Packet-Radio-Users-Group/QRP_AM_Transceiver_JK1MLY/README.md

ブロックダイアグラムが学べる　QRPトランシーバ基板

無線機の基本的な動作を知るため、振幅変調（amplitude modulation）を使った簡易的な無線機を作り、回路の定数やデバイスを変えたり、動作波形を見たりするする基板について扱う

以下の構成でファイルは保存する

assembly  提供する基板に部品を実装する手引き　pdf版の回路図、excel版の部品表を含む

caddata   KiCadのデータ

document  使っている部品、基板などに関する情報

guidance  どのように実験をしていくかの手引き
