Packet-Radio-Users-Group/QRP_AM_Transceiver_JK1MLY/caddata/README.md

KICadデータ

am-pcb1
　思い立って最初に作ったもの
（この基板で実験して、28M・10mWの免許を取得）

am-pcb2
　pcb1を作り直そうとしたもの
（リファイン前提で先に番号を取ったが色々と変えることにしてボツ）

am-pcb3
　受信のミキサをICにしたもの
（動作を学ぶためにはトランジスタの考えに戻ってボツ）

am-pcb4
　実験用として使うための改良
（ハムフェア2024で頒布）
