Packet-Radio-Users-Group/QRP_AM_Transceiver_JK1MLY/document/pcb4-7m-bom.xls

/Users/inaba/Documents/KICad/Feb28/pcb4/pcb4-7m/pcb4-7m.kicad_sch
2024 August 12, Monday 16:06:50
Qty | Reference(s) | Value | DNP | Datasheet
2 | C1, C2 | 100u |  | https://akizukidenshi.com/catalog/g/g110598/
27 | C3, C4, C5, C6, C7, C8, C9, C11, C21, C31, C32, C33, C39, C52, C53, C55, C56, C58, C60, C61, C71, C74, C78, C80, C91, C92, C93 | 0.1u |  | https://akizukidenshi.com/catalog/g/g113582/
10 | C12, C13, C14, C16, C22, C41, C62, C73, C79, C86 | 1000p |  | http://www.maroon.dti.ne.jp/satodenki/cap.html#celamic50v
9 | C15, C24, C25, C36, C37, C63, C65, C67, C72 | 100p |  | http://www.maroon.dti.ne.jp/satodenki/cap.html#celamic50v
1 | C23 | 120p |  | http://www.maroon.dti.ne.jp/satodenki/cap.html#celamic50v
2 | C26, C68 | 22p |  | http://www.maroon.dti.ne.jp/satodenki/cap.html#celamic50v
1 | C34 | 330p |  | http://www.maroon.dti.ne.jp/satodenki/cap.html#celamic50v
5 | C35, C45, C46, C47, C48 | 150p | DNP | http://www.maroon.dti.ne.jp/satodenki/cap.html#celamic50v
2 | C38, C66 | 100p | DNP | http://www.maroon.dti.ne.jp/satodenki/cap.html#celamic50v
2 | C42, C44 | 3300p |  | http://www.maroon.dti.ne.jp/satodenki/cap.html#celamic50v
1 | C43 | 4700p |  | http://www.maroon.dti.ne.jp/satodenki/cap.html#celamic50v
8 | C51, C54, C57, C59, C75, C76, C77, C81 | 10u |  | https://akizukidenshi.com/catalog/g/g103095/
4 | C64, C94, C95, C96 | 10p | DNP | http://www.maroon.dti.ne.jp/satodenki/cap.html#celamic50v
1 | C69 | 30pF | DNP | https://akizukidenshi.com/catalog/g/g115472/
2 | C82, C84 | 470p |  | http://www.maroon.dti.ne.jp/satodenki/cap.html#celamic50v
1 | C83 | 820p |  | http://www.maroon.dti.ne.jp/satodenki/cap.html#celamic50v
1 | C85 | 10p |  | http://www.maroon.dti.ne.jp/satodenki/cap.html#celamic50v
1 | D21 | 1S2638 | DNP | https://akizukidenshi.com/catalog/g/g113795/
2 | D81, D82 | 1SS106 |  | https://akizukidenshi.com/catalog/g/g113881/
1 | D91 | LED-G |  | https://akizukidenshi.com/catalog/g/g111637/
1 | D92 | LED-R |  | https://akizukidenshi.com/catalog/g/g111577
1 | IC51 | UTC7642 |  | https://akizukidenshi.com/catalog/g/g112082/
2 | J91, J92 | Conn_Coaxial | DNP | https://akizukidenshi.com/catalog/g/g101422/
1 | J93 | AudioJack4 | DNP | https://akizukidenshi.com/catalog/g/g106070/
1 | J94 | AudioJack2_Ground | DNP | https://akizukidenshi.com/catalog/g/g112478/
1 | J95 | AudioJack3 | DNP | https://akizukidenshi.com/catalog/g/g102460/
1 | K91 | Y14H-1C-9DS | DNP | https://akizukidenshi.com/catalog/g/g102003/
2 | L11, L71 | 100u |  | https://akizukidenshi.com/catalog/g/g103966/
1 | L21 | 10u | DNP | https://akizukidenshi.com/catalog/g/g103963/
1 | L22 | 100u | DNP | https://akizukidenshi.com/catalog/g/g103966/
2 | L41, L42 | 4.7u |  | https://akizukidenshi.com/catalog/g/g103962/
1 | L61 | 1u | DNP | https://akizukidenshi.com/catalog/g/g103961/
2 | L81, L82 | 1u |  | https://akizukidenshi.com/catalog/g/g103961/
1 | Q11 | BF256B |  | https://akizukidenshi.com/catalog/g/g117515/
4 | Q21, Q31, Q61, Q71 | 2SC1959 |  | https://akizukidenshi.com/catalog/g/g113827/
7 | R11, R12, R15, R21, R31, R35, R61 | 100 |  | https://akizukidenshi.com/catalog/g/g125101/
3 | R13, R53, R76 | 100k |  | https://akizukidenshi.com/catalog/g/g125104/
2 | R14, R75 | 22k |  | https://akizukidenshi.com/catalog/g/g125223/
6 | R22, R23, R32, R62, R63, R71 | 47k |  | https://akizukidenshi.com/catalog/g/g118208/
1 | R24 | 100 | DNP | https://akizukidenshi.com/catalog/g/g125101/
1 | R25 | 10k | DNP | https://akizukidenshi.com/catalog/g/g108012/
1 | R26 | 10k | DNP | https://akizukidenshi.com/catalog/g/g125103/
2 | R27, R64 | 2.2k |  | https://akizukidenshi.com/catalog/g/g125222/
1 | R28 | 0 | DNP | https://akizukidenshi.com/catalog/g/g125000/
1 | R29 | 0 |  | https://akizukidenshi.com/catalog/g/g125000/
1 | R33 | 10k |  | https://akizukidenshi.com/catalog/g/g125103/
1 | R34 | 220 |  | https://akizukidenshi.com/catalog/g/g125221/
1 | R51 | 3.3k |  | https://akizukidenshi.com/catalog/g/g125332/
2 | R52, R74 | 10 |  | https://akizukidenshi.com/catalog/g/g125100/
1 | R54 | 10k |  | https://akizukidenshi.com/catalog/g/g108012/
1 | R72 | 6.8k |  | https://akizukidenshi.com/catalog/g/g125682/
1 | R73 | 22 |  | https://akizukidenshi.com/catalog/g/g103821/
1 | R81 | 1M | DNP | https://akizukidenshi.com/catalog/g/g125105/
2 | R91, R92 | 1k |  | https://akizukidenshi.com/catalog/g/g125102/
1 | T11 | 7T7 |  | http://www.maroon.dti.ne.jp/satodenki/l.html#fcz
2 | T21, T61 | 7T7 |  | http://www.maroon.dti.ne.jp/satodenki/l.html#fcz
1 | T31 | 7T1R0 |  | http://www.maroon.dti.ne.jp/satodenki/l.html#fcz
2 | T41, T42 | 7T1R0 | DNP | http://www.maroon.dti.ne.jp/satodenki/l.html#fcz
1 | T62 | 7T7 | DNP | http://www.maroon.dti.ne.jp/satodenki/l.html#fcz
1 | T71 | 7T7 |  | http://www.maroon.dti.ne.jp/satodenki/l.html#fcz
1 | T91 | 7T50 | DNP | http://www.maroon.dti.ne.jp/satodenki/l.html#fcz
1 | U41 | 455BU | DNP | https://akizukidenshi.com/catalog/g/g116045/
2 | U51, U71 | LM386 |  | https://akizukidenshi.com/catalog/g/g114548/
1 | U91 | Microphone | DNP | https://akizukidenshi.com/catalog/g/g101810/
1 | X21 | 6.7458M |  | http://www.maroon.dti.ne.jp/satodenki/l.html#hc49
1 | X61 | 7.195M |  | http://www.maroon.dti.ne.jp/satodenki/l.html#hc49
