Packet-Radio-Users-Group/QRP_AM_Transceiver_JK1MLY/assembly/README.md

組み立て

一般的な電子工作の手引きを探して下さい
部品の実装場所、定数などはdocument下のファイルを見て下さい
