Packet-Radio-Users-Group/QRP_AM_Transceiver_JK1MLY/guidance/step-by-step.txt

実験の手引き

ブロック図

送信
MIC---MOD---LPF---ANT
       |
       |
      TLO

受信
ANT---AMP---MIX---BPF---DET---SPK
             |
             |
            RLO

順番に作っていく

DET
AMラジオ用のICを使っている受信用の回路
適当に線をつなぐことでAMラジオが聞こえることで動作確認
ユニバーサル部にあるイヤホン端子を介して接続することも可能

RFチェッカー
ユニバーサル部分にダイオードの検波回路を組む
オシロスコープが使える場合には不要

RLO
受信した周波数を変えるための受信用の発振回路
RFチェッカーのレベルが高くなるように調整

TLO
送信する周波数を作るための発振回路
RFチェッカーのレベルが高くなるように調整

AMP
受信した信号を増幅するための回路
TLOからの信号のレベルを下げて入力
RFチェッカーのレベルが高くなるように調整

MIX
受信した信号の周波数を変換するための回路
AMPからの信号を入力
この段階で調整は無し

BPF
選択度を少しでも上げる場合はT41を使用
TLOとRLOの差が455kHz程度にできる場合はU81を使用
RFチェッカーのレベルが高くなるようMIXを調整
T41を使う場合のカップリングは10pF程度

MOD + LPF
AM変調するための回路
TLOからの信号をMODに入れる（本来の接続）
マイクは接続しない
RFチェッカーのレベルが高くなるように調整

マイクを接続
ユニバーサル部にあるパターンを使って接続することも可能
ユニバーサル部にあるイヤホン端子を介して接続することも可能
イヤホン兼用の4Pタイプではないので注意

送受とも電源を供給
送信している電波が聞こえるか確認
マイクとスピーカの位置によってはハウリング

送受切替
2回路のスイッチでアンテナと電源を切替
ON-OFF-(ON)タイプを使うと電源スイッチを兼ねることも可能
　例MS500IB NKK A-29AP

パワーアップ
アンテナさえ付けなければ微弱程度な状態から改造
　220Ωの抵抗を小さくor無くすと10mW程度になるハズ

エミッタ注入
ローカルをベースからエミッタに変更

発振回路の実験
バリキャップを使って周波数可変にしてみる
　受信帯域幅が広いので実用としての意味はない

免許の申請
実際に電波を出せる無線局にしてみる

選んだ周波数
  16.9344  CD 41.1k
  28.375   PAL 795x596

他の周波数
　例7.181と7.000
