Packet-Radio-Users-Group/QRP_AM_Transceiver_JK1MLY/document/pcb4-50m-cir.pdf

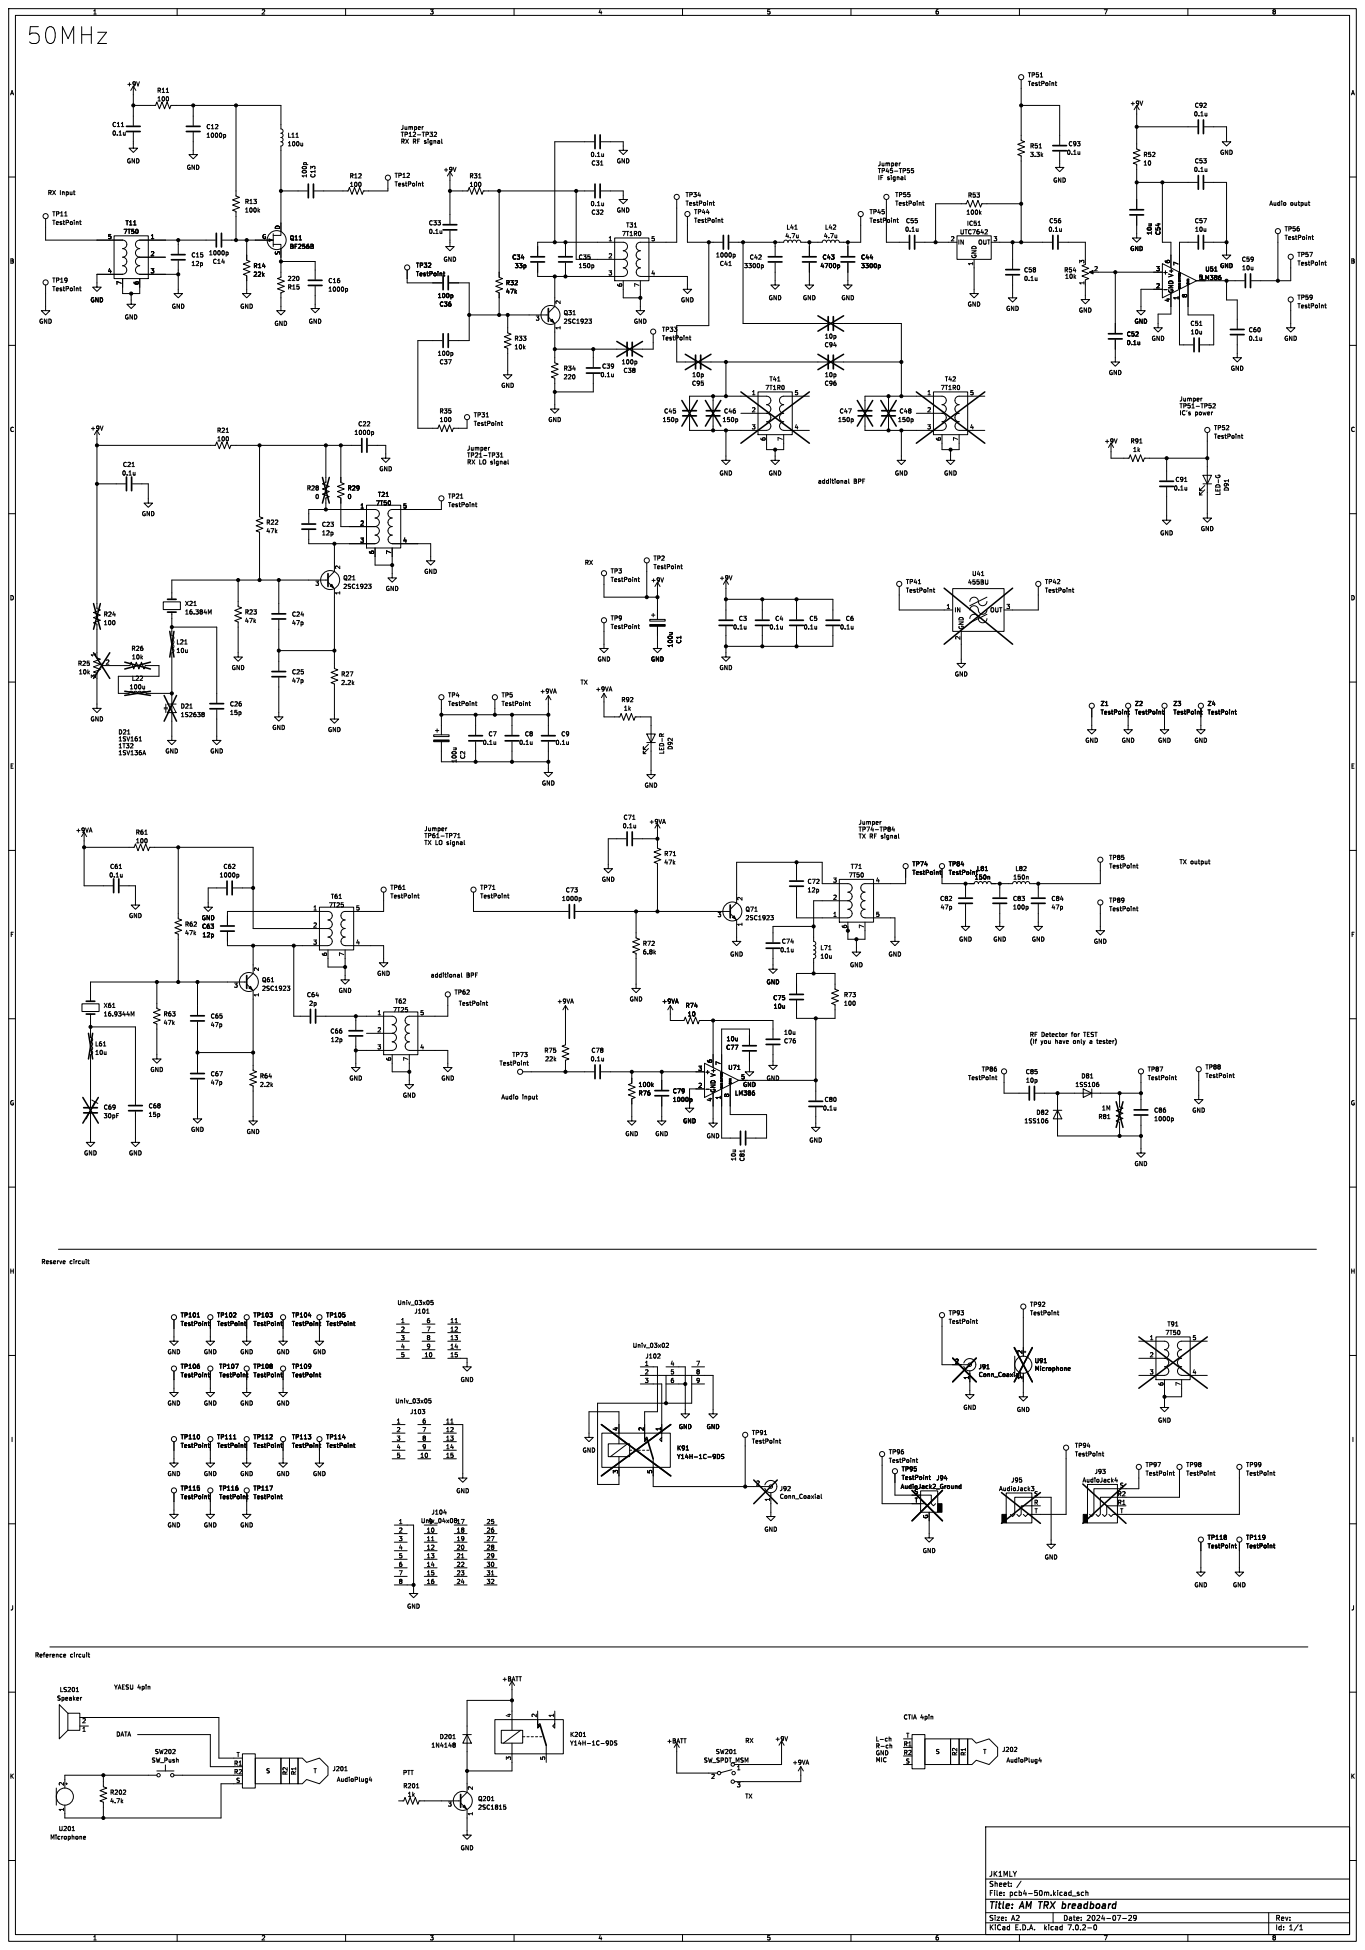
[picture p9: page 1]

Jumper TP12-TP32 RX RF signal

Jumper TP21-TP31 RX LO signal

Jumper TP74-TP84 TX RF signal

RF Detector for TEST
(If you have only a tester)

L-ch R-ch GND MIC

Id: 1/1 Title: AM TRX breadboard
