Packet-Radio-Users-Group/QRP_AM_Transceiver_JK1MLY/document/pcb4-28m-as.pdf

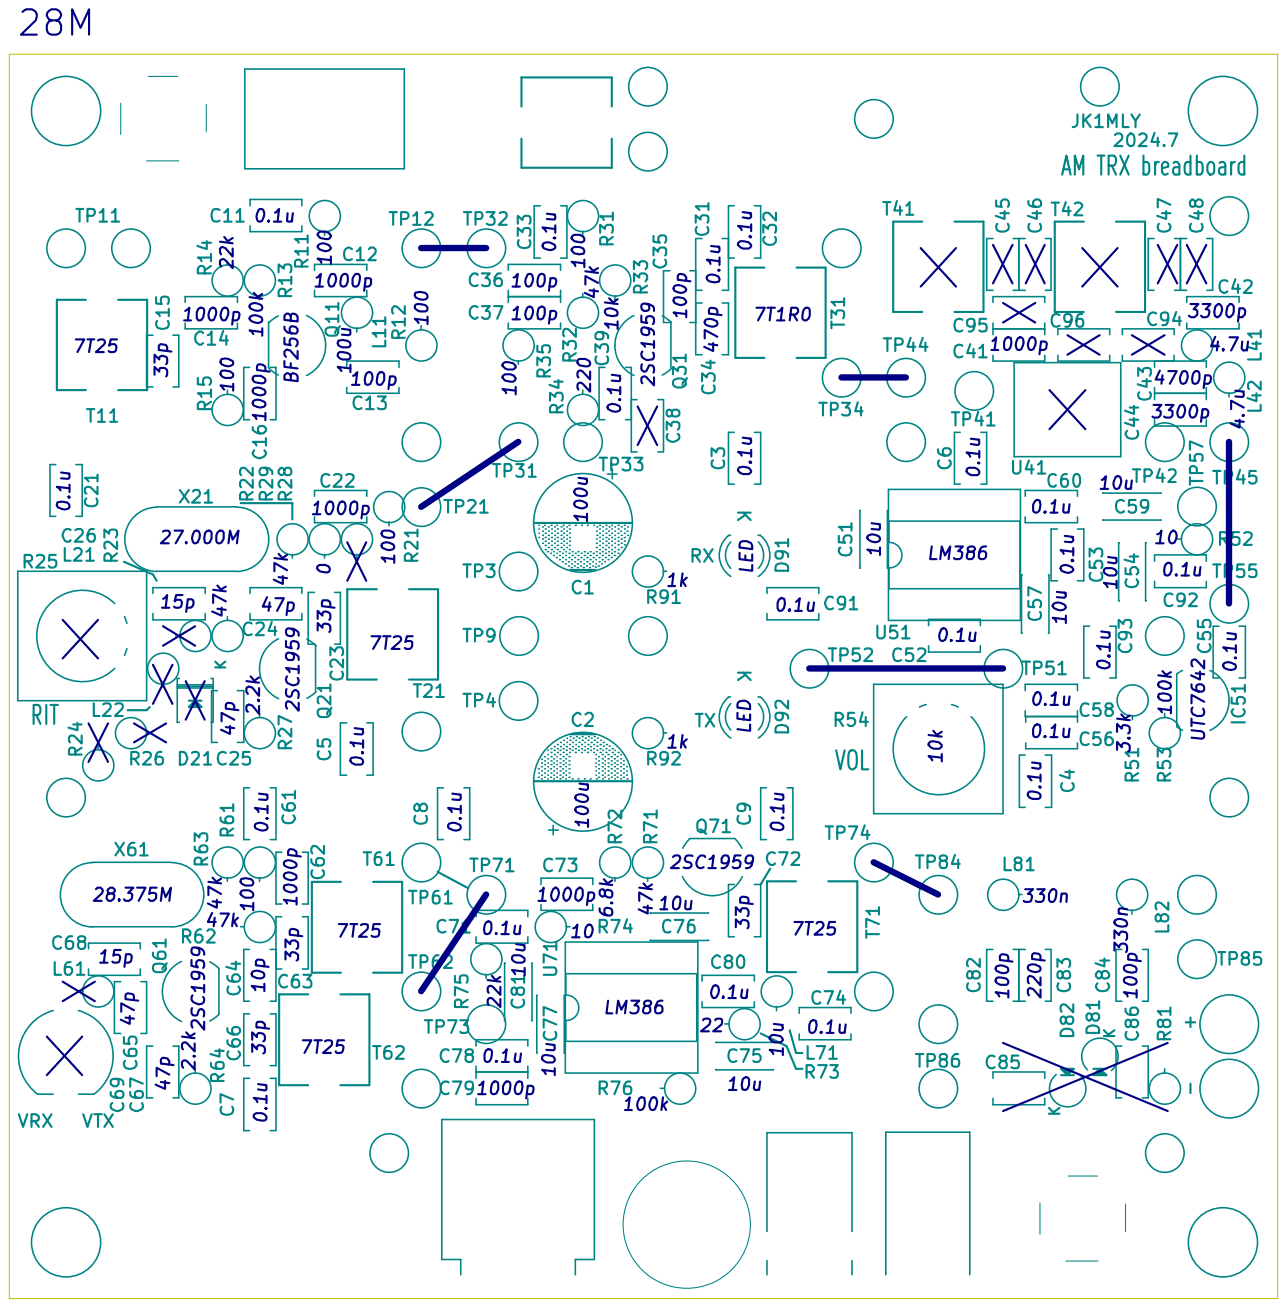
[picture p10: page 1]
