Packet-Radio-Users-Group/QRP_AM_Transceiver_JK1MLY/document/pcb4-50m-as.pdf

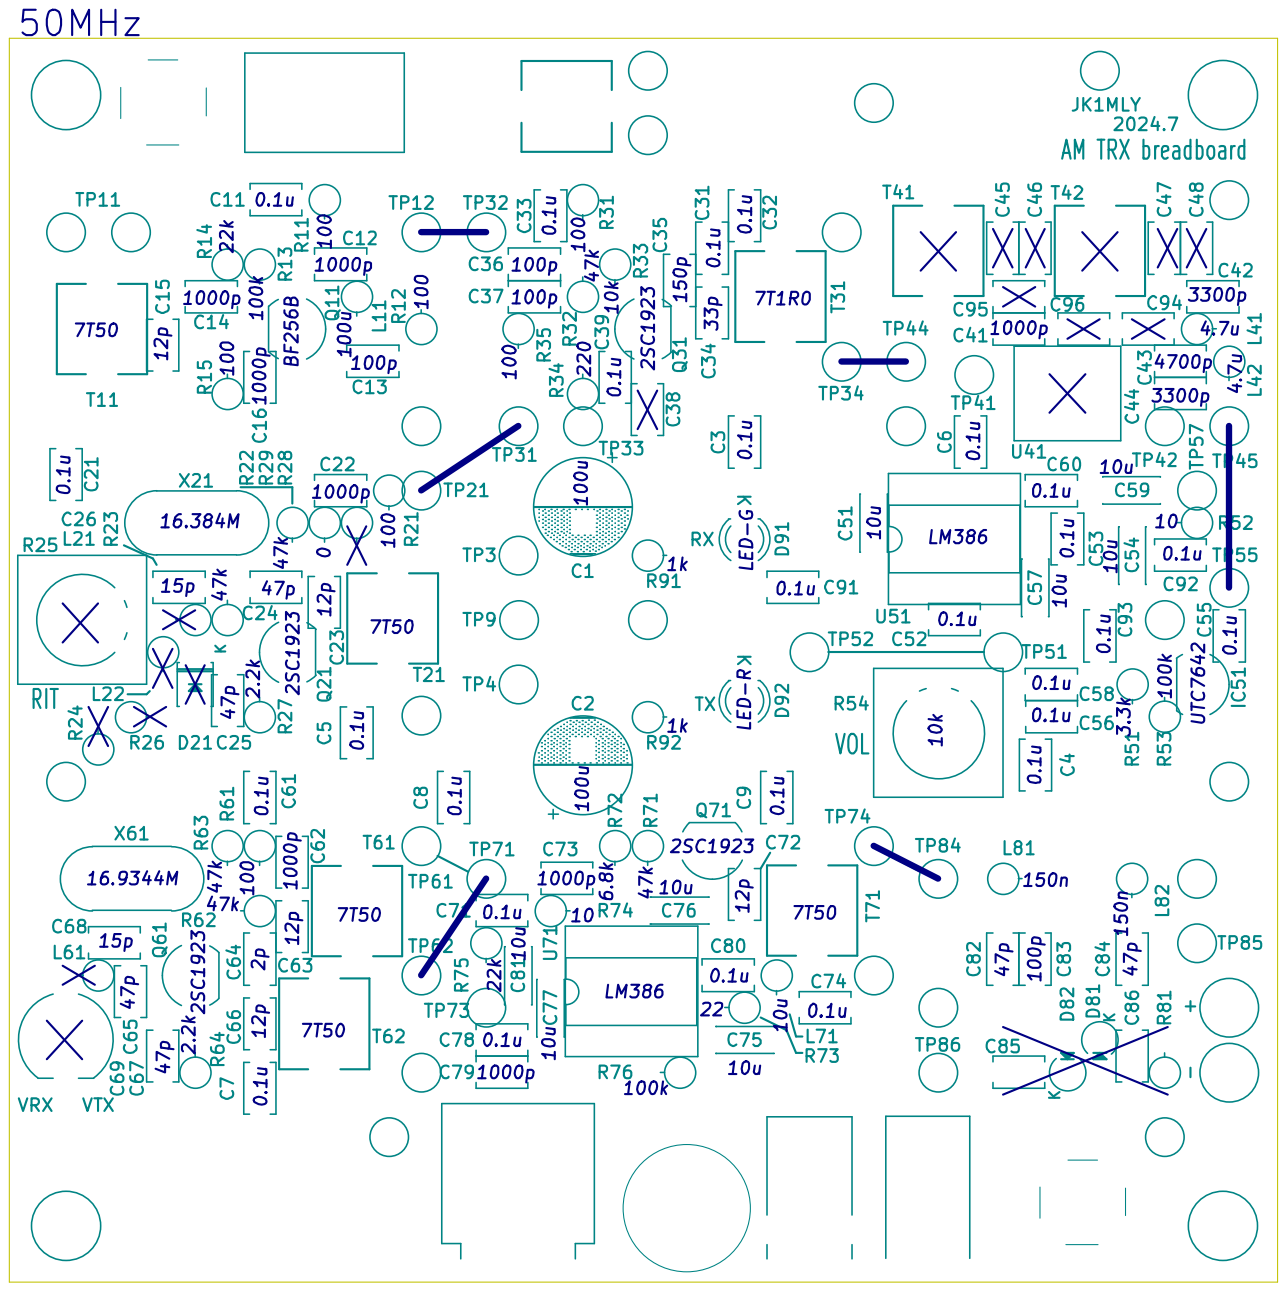
[picture p11: page 1]
