Packet-Radio-Users-Group/QRP_AM_Transceiver_JK1MLY/document/pcb4-7m-as.pdf

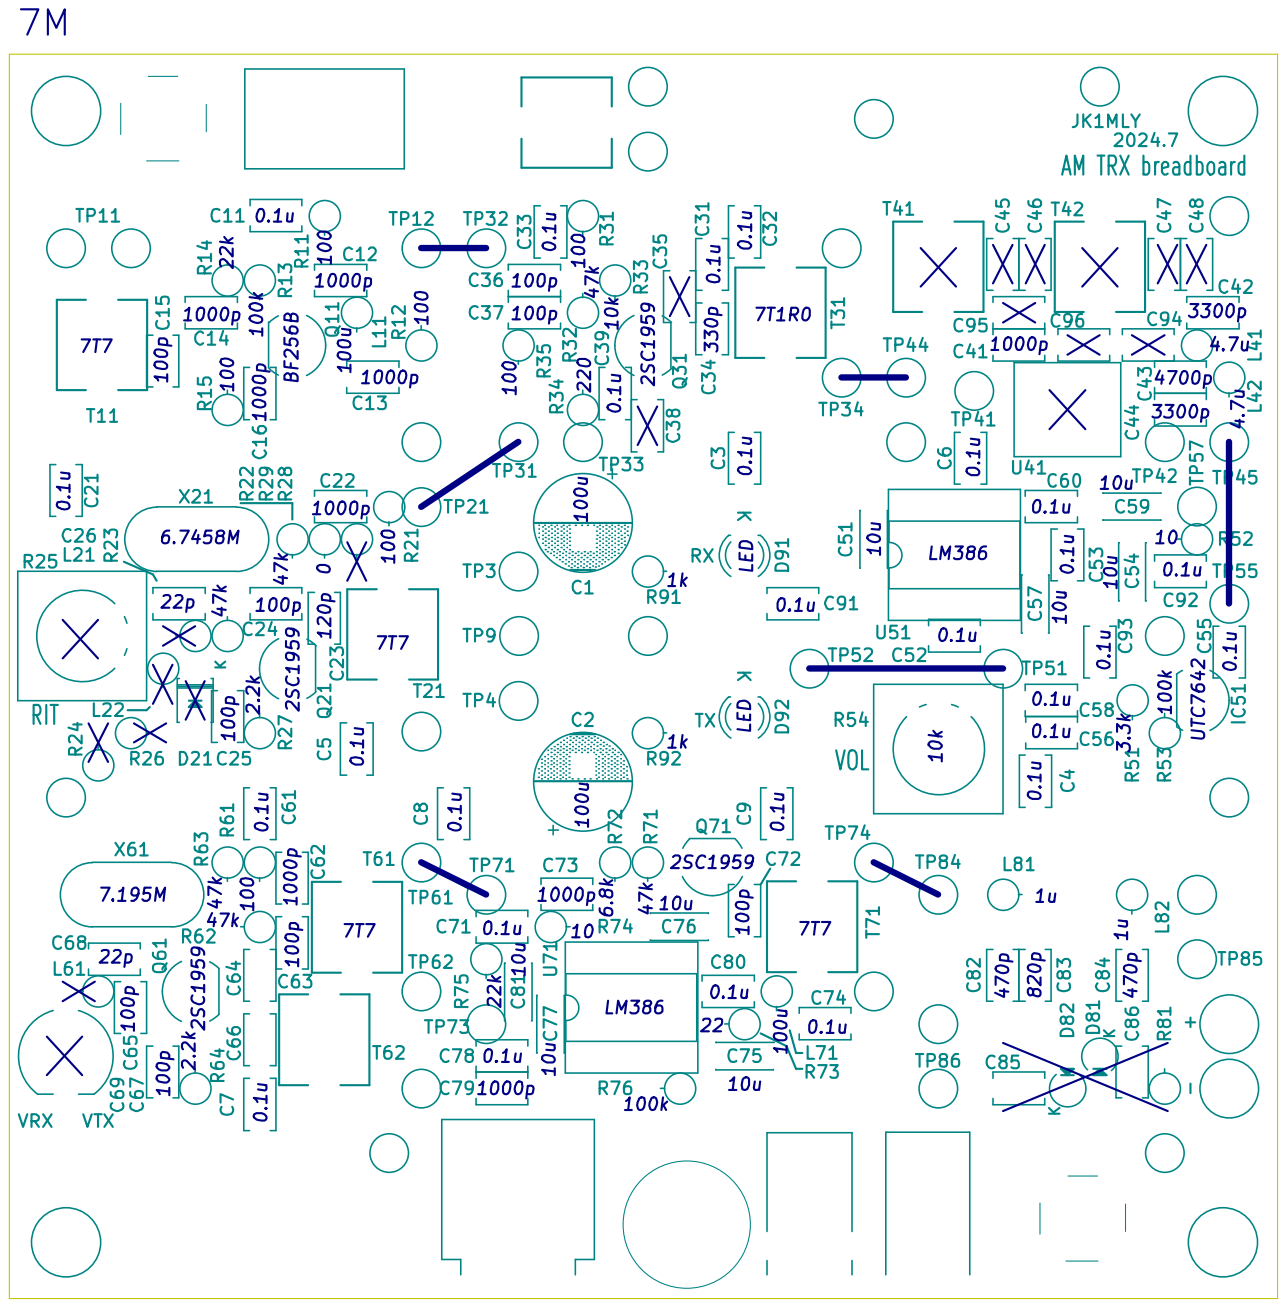
[picture p12: page 1]
