Packet-Radio-Users-Group/QRP_AM_Transceiver_JK1MLY/document/pcb4-7m-cir.pdf

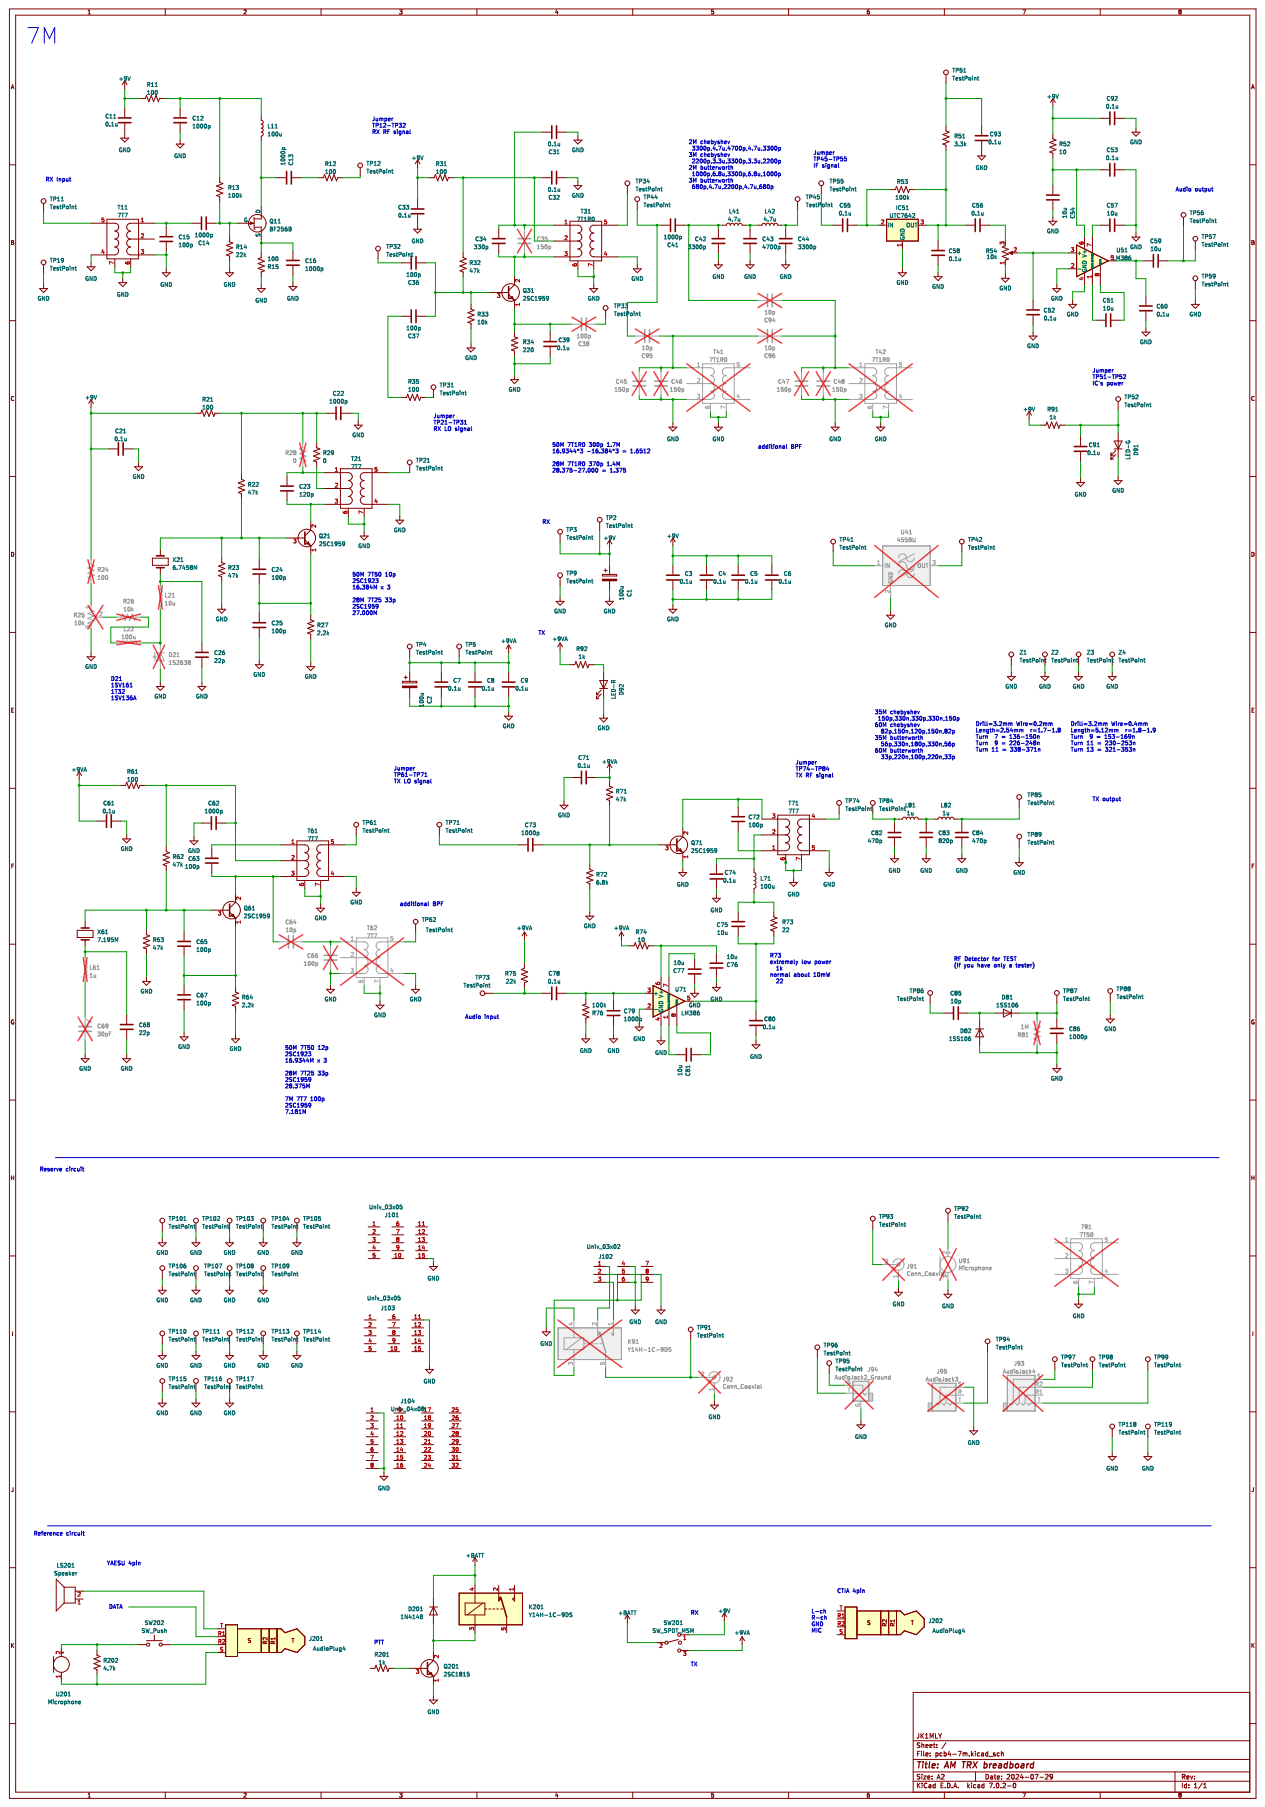
[picture p13: page 1]
