Packet-Radio-Users-Group/QRP_AM_Transceiver_JK1MLY/caddata/twint/twint.kicad_pcb

## KiCad design caddata/twint/twint.kicad_pcb (2024-08-23)

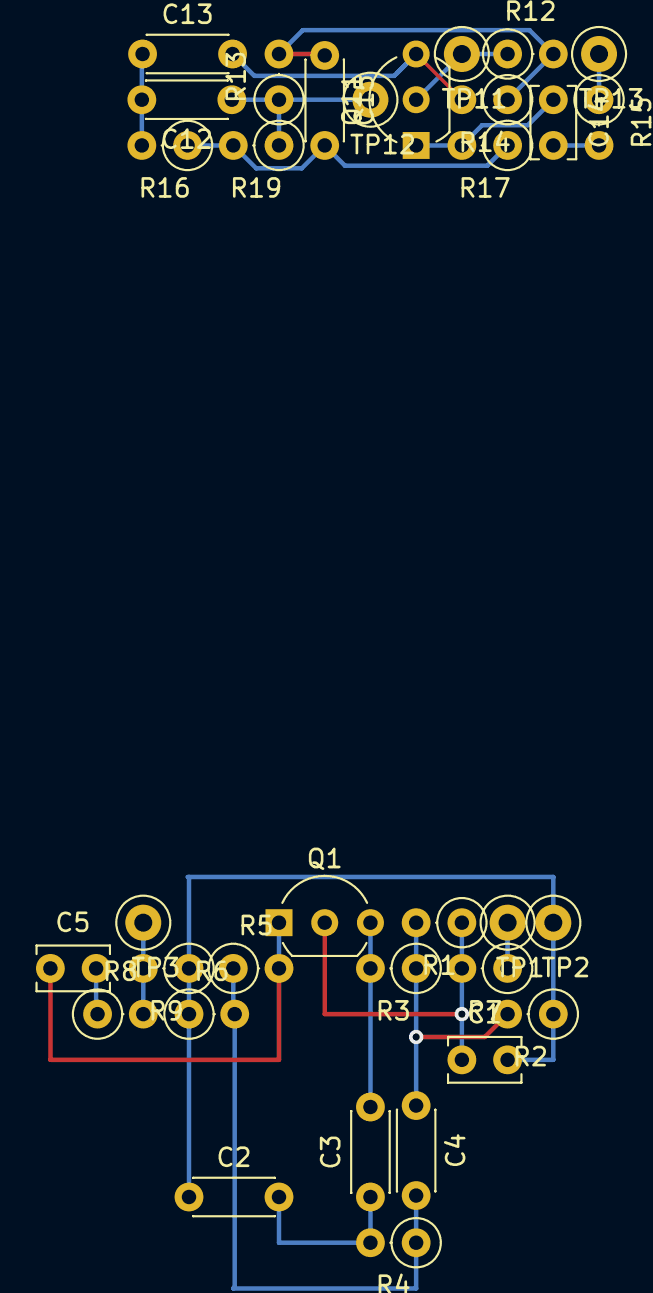
[picture p14: board twint.kicad_pcb from above]

Board: 2 copper layers, 33 parts (0 on the bottom side), 18 nets.

Parts:
C1, C5, C14: 0.1u; C_Disc_P2.54mm
C2, C3, C12, C13: 0.01u; C_Disc_P5.12mm
C4, C15: 0.033u; C_Disc_P5.12mm
Q1, Q11: 2SC1815; TO-92_Inline_Wide
R1, R12: 22k; R_Axial_DIN0207_L6.3mm_D2.5mm_P2.54mm_Vertical
R2, R13: 33k; R_Axial_DIN0207_L6.3mm_D2.5mm_P2.54mm_Vertical
R3: 10k; R_Axial_DIN0207_L6.3mm_D2.5mm_P2.54mm_Vertical
R4, R16: 4.7k; R_Axial_DIN0207_L6.3mm_D2.5mm_P2.54mm_Vertical
R5, R7, R17: 100; R_Axial_DIN0207_L6.3mm_D2.5mm_P2.54mm_Vertical
R6, R19: 3.3k; R_Axial_DIN0207_L6.3mm_D2.5mm_P2.54mm_Vertical
R8, R15: 100k; R_Axial_DIN0207_L6.3mm_D2.5mm_P2.54mm_Vertical
R9: 1k; R_Axial_DIN0207_L6.3mm_D2.5mm_P2.54mm_Vertical
R14: 15k; R_Axial_DIN0207_L6.3mm_D2.5mm_P2.54mm_Vertical
TP1, TP11: VCC; TestPoint_Loop_D2.50mm_Drill1.0mm
TP2, TP12: GND; TestPoint_Loop_D2.50mm_Drill1.0mm
TP3, TP13: OUT; TestPoint_Loop_D2.50mm_Drill1.0mm

Connections:
GND: C1.2, C2.1, C12.1, R2.1, R6.1, R9.1, R13.1, R19.1, TP2.1, TP12.1
unnamed: C2.2, C3.1, R4.2
unnamed: C4.1, R1.2, R2.2, R3.1
unnamed: C4.2, R4.1, R5.1, R6.2
unnamed: C5.2, R8.1
unnamed: C12.2, C13.1, R16.2
unnamed: C14.2, R15.2
unnamed: C15.1, R12.2, R13.2, R14.1
unnamed: C15.2, R16.1, R17.1, R19.2
unnamed: C3.2, Q1.3 (B), R3.2
unnamed: C1.1, Q1.2 (C), R1.1, R7.2
unnamed: C5.1, Q1.1 (E), R5.2
unnamed: C13.2, Q11.3 (B), R14.2
unnamed: Q11.2 (C), R12.1
unnamed: C14.1, Q11.1 (E), R17.2
unnamed: R7.1, TP1.1
unnamed: R8.2, R9.2, TP3.1
unnamed: R15.1, TP13.1
