Packet-Radio-Users-Group/QRP_AM_Transceiver_JK1MLY/(commit log)

2024-07-14 Add files
    KICADデータ2種am-pcb1と3を追加
    [am-pcb1-B_Cu.gbr, am-pcb1-B_Mask.gbr, am-pcb1-B_Paste.gbr, am-pcb1-B_Silkscreen.gbr, am-pcb1-Edge_Cuts.gbr, am-pcb1-F_Cu.gbr, am-pcb1-F_Mask.gbr, am-pcb1-F_Paste.gbr]
2024-07-18 step-by-step.txt を更新
2024-07-29 update
    add am-pcb2 ,4
    [am-pcb2-B_Cu.gbr, am-pcb2-B_Mask.gbr, am-pcb2-B_Paste.gbr, am-pcb2-B_Silkscreen.gbr, am-pcb2-Edge_Cuts.gbr, am-pcb2-F_Cu.gbr, am-pcb2-F_Mask.gbr, am-pcb2-F_Paste.gbr]
